2635Lakemonsters/BunnyBots2024_Arduino/sensor-strip-pcb/sensor-strip-pcb.kicad_pcb

## KiCad design sensor-strip-pcb/sensor-strip-pcb.kicad_pcb (2024-11-27)

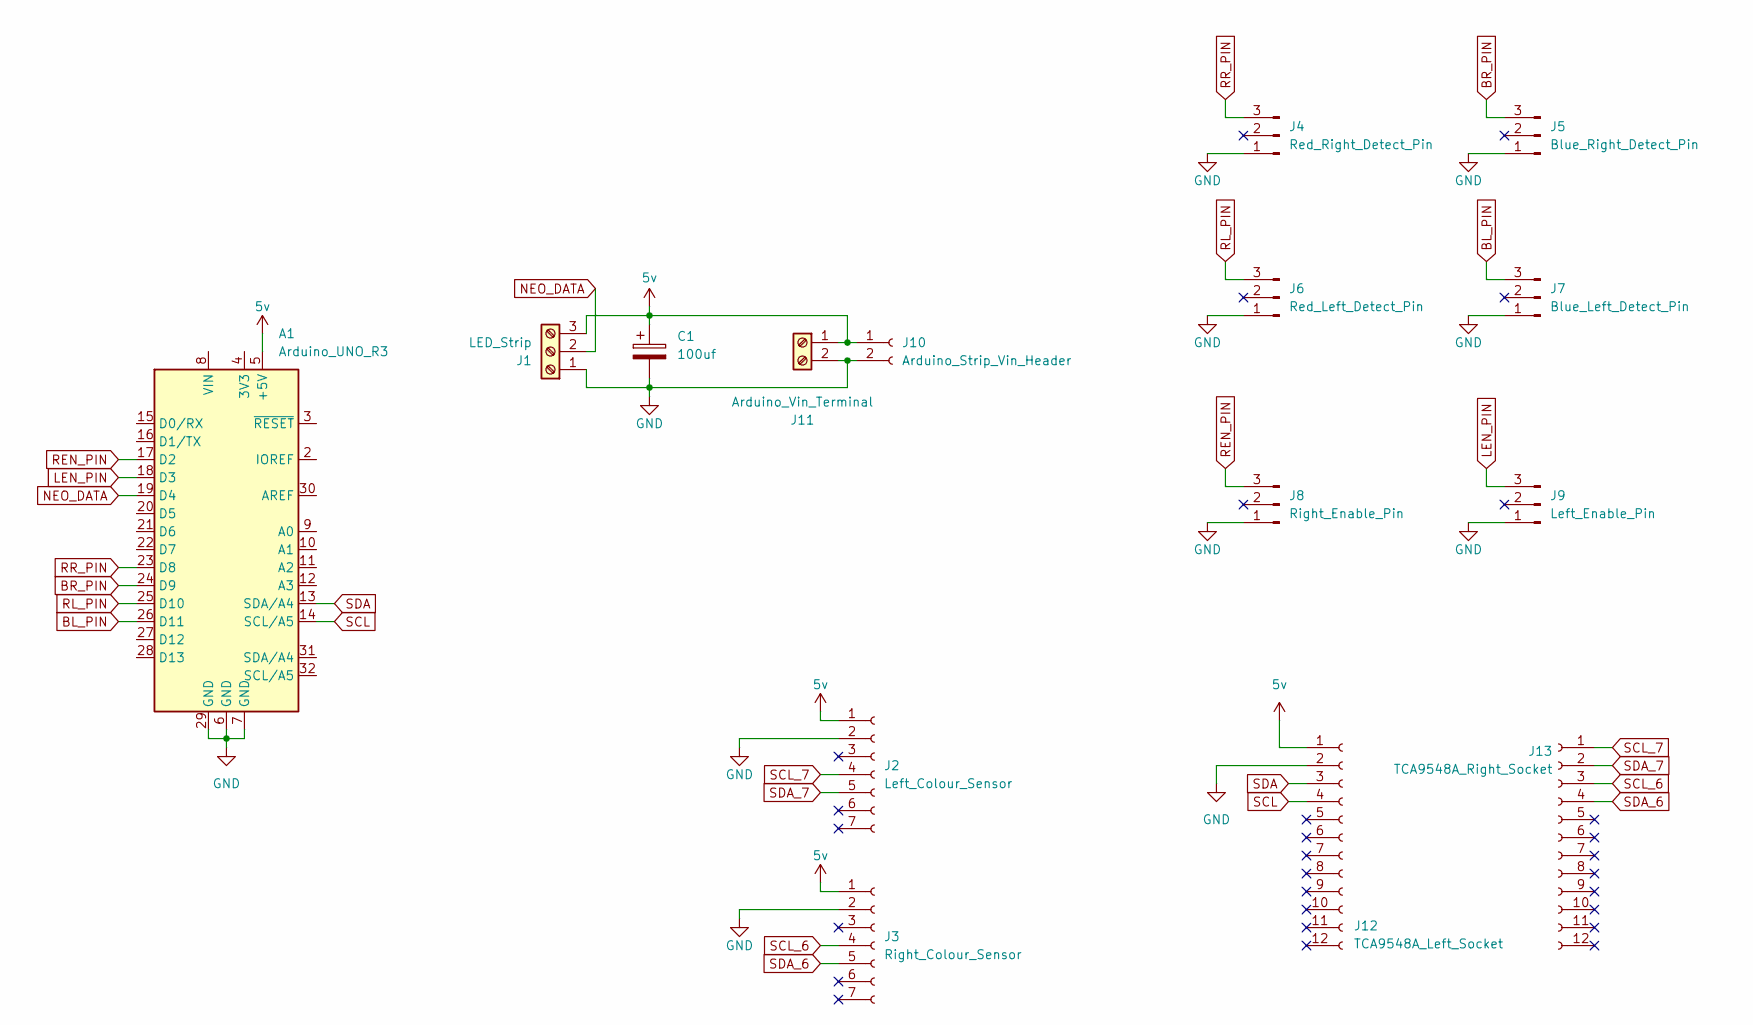
[picture p1: schematic sensor-strip-pcb.kicad_sch]

Parts:
A1: Arduino_UNO_R3; Arduino_UNO_R3_WithMountingHoles
C1: 100uf; CP_Radial_D8.0mm_P5.00mm
J1: LED_Strip; TerminalBlock_bornier-3_P5.08mm
J2: Left_Colour_Sensor; PinHeader_1x07_P2.54mm_Vertical
J3: Right_Colour_Sensor; PinHeader_1x07_P2.54mm_Vertical
J4: Red_Right_Detect_Pin; PinHeader_1x03_P2.54mm_Vertical
J5: Blue_Right_Detect_Pin; PinHeader_1x03_P2.54mm_Vertical
J6: Red_Left_Detect_Pin; PinHeader_1x03_P2.54mm_Vertical
J7: Blue_Left_Detect_Pin; PinHeader_1x03_P2.54mm_Vertical
J8: Right_Enable_Pin; PinHeader_1x03_P2.54mm_Vertical
J9: Left_Enable_Pin; PinHeader_1x03_P2.54mm_Vertical
J10: Arduino_Strip_Vin_Header; PinSocket_1x02_P2.54mm_Vertical
J11: Arduino_Vin_Terminal; TerminalBlock_bornier-2_P5.08mm
J12: TCA9548A_Left_Socket; PinSocket_1x12_P2.54mm_Vertical
J13: TCA9548A_Right_Socket; PinSocket_1x12_P2.54mm_Vertical

Connections:
5v: A1.5 (+5V), C1.1, J1.3, J2.1, J3.1, J10.1, J11.1, J12.1
BL_PIN: A1.26 (D11), J7.3
BR_PIN: A1.24 (D9), J5.3
GND: A1.6 (GND), A1.7 (GND), A1.29 (GND), C1.2, J1.1, J2.2, J3.2, J4.1, J5.1, J6.1, J7.1, J8.1, J9.1, J10.2, J11.2, J12.2
LEN_PIN: A1.18 (D3), J9.3
NEO_DATA: A1.19 (D4), J1.2
REN_PIN: A1.17 (D2), J8.3
RL_PIN: A1.25 (D10), J6.3
RR_PIN: A1.23 (D8), J4.3
SCL: A1.14 (SCL/A5), J12.4
SCL_6: J3.4, J13.3
SCL_7: J2.4, J13.1
SDA: A1.13 (SDA/A4), J12.3
SDA_6: J3.5, J13.4
SDA_7: J2.5, J13.2

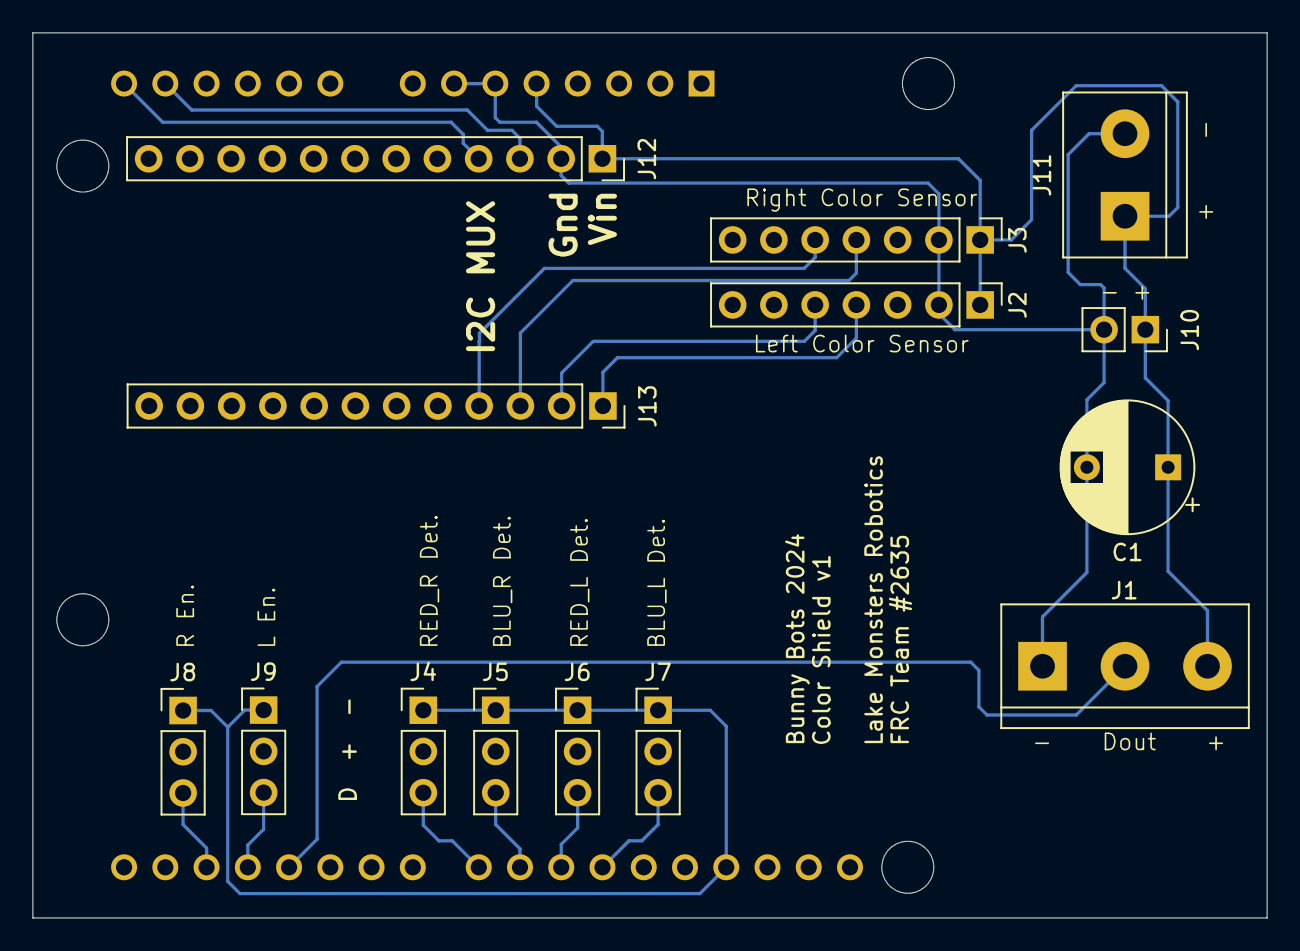
[picture p2: board sensor-strip-pcb.kicad_pcb from above]

Board: 2 copper layers, 76.0 x 54.5 mm, 15 parts (1 on the bottom side), 15 nets.
