2635Lakemonsters/BunnyBots2024_Arduino/(threads)

Thread 2 (2024-10-20):

Color Sensors for Arduino

jwaltner, 2024-10-20:
- [ ] Create code for using a color sensor on an Arduino
  - [ ] code for using the color sensor.
  - [ ] code for processing the color sensor data and setting thresholds
  - [ ] additional items???
- [ ] Document code
  * all methods have comments describing what it does
  * PRE conditions documented
  * POST conditions documentd
- [ ] Create Tutorial explaining how to do it for MonsterDocs.
  * photos of of hardware pieces tying to the code.
  * description of code with code blocks that controls the hardware.
  * appropriate external links to external references for additional information.
  * The intent here is something that we could give to new members for training, another robotics team to show them how we did it, and/or a high school teacher interested in practical arduino labs.

jwaltner, 2024-10-20:
@venomboss985 , same deal here, lets get the examples made and take the opportunity document items.  @An-JieYu , these will be additional candidates for outreach projects.

Thread 3 (2024-10-20):

Arduino output to DIO

jwaltner, 2024-10-20:
- [ ] Create code for read / write from DIO on roboRio
  - [ ] code for write to DIO
  - [ ] code for read from DIO
  - [ ] additional items???  While we are at it should we also do PWM or other?
- [ ] Document code
  * all methods have comments describing what it does
  * PRE conditions documented
  * POST conditions documentd
- [ ] Create Tutorial explaining how to do it for MonsterDocs.
  * photos of of hardware pieces tying to the code.
  * description of code with code blocks that controls the hardware.
  * appropriate external links to external references for additional information.
  * The intent here is something that we could give to new members for training, another robotics team to show them how we did it, and/or a high school teacher interested in practical arduino labs.

jwaltner, 2024-10-20:
@venomboss985 , tagging you for visibility on this issue.

Thread 4 (2024-10-20):

Wrap up full package for Bunny Bots

jwaltner, 2024-10-20:
Take all of the pieces and create an integrated package to deploy on the Arduino to support bunny bots 2024.

jwaltner, 2024-10-20:
@venomboss985 , tagging you for visibility on this issue.

venomboss985, 2024-11-21:
# FINAL TODO

- [ ] DOCS
  - [ ] Document Arduino code on MonsterDocs (ie. how are variables/functions setup, what each function does, explain `setup()` and `loop()`, etc.)
  - [ ] Make an installation guide for Arduino code (ie. Install Arduino IDE, install correct libraries, specify compatible boards, etc.)
  - [ ] Document robot DIO code on MonsterDocs (ie. how do you set up and use a DIO pin as an input or an output)
- [ ] CODE CLEANUP
  - [ ] Remove unnecessary function repetitions
  - [ ] Rename variables, functions, and objects to C++/Java standard conventions

Thread 5 (2024-12-08):

Create report of troubleshooting for Arduino hat.

jwaltner, 2024-12-08:
@venomboss985 ,  work with @Preston-Hegouaburu  to create a MonsterDoc documenting what you guys did on Dec 7th with the Arduino hat.  What were the problems, what worked, what didn't, and troubleshooting steps.

Notes from Slack from Preston:
```
We had a couple of issues with the Arduino today, and here is what happened: 1. The LED strip was flickering and was displaying random colors. this was due to the fact that the ground references on the were separated but once we connected them the issue was fixed. 2. Before resolving this issue however, we created another by using a different LED strip to test to see if the original LED strip was the thing causing the issue. When we plugged it into the Arduino we got the ground and 5 V switched and melted 2 wires. Luckily none of the wires on the PCB were effected so there was no lasting damage to any components
```
