2635Lakemonsters/BunnyBots2024_Arduino/(commit log)

2024-10-24 Create RGBSensorExample.ino
    I got the color sensor to work, and did some multiplexer stuff :)
2024-10-29 Sensors and LED integration
2024-11-14 Improved detection process and starter calibration values
    We changed the integration time of the color sensor to be 2.4 milliseconds rather than 614. And changed the threshold value system. Progressed on code cleaning.
2024-11-21 Initial commit for PCB schematics
    [sensor-strip-pcb.kicad_pcb, sensor-strip-pcb.kicad_sch]
2024-11-23 Updated layout and traces, needs I2C MUX
    [sensor-strip-pcb.kicad_pcb]
2024-11-24 Finalized layout and trace routing
    [sensor-strip-pcb.kicad_pcb, sensor-strip-pcb.kicad_sch]
2024-11-27 Finished silkscreen, finalized v1
    [sensor-strip-pcb.kicad_pcb, sensor-strip-pcb.kicad_sch]
